Papproni/stm_audio_board_v3_dsp_board/stm_audio_board_V3/stm_audio_board_V3.kicad_pcb

## KiCad design stm_audio_board_V3/stm_audio_board_V3.kicad_pcb (2024-04-08)

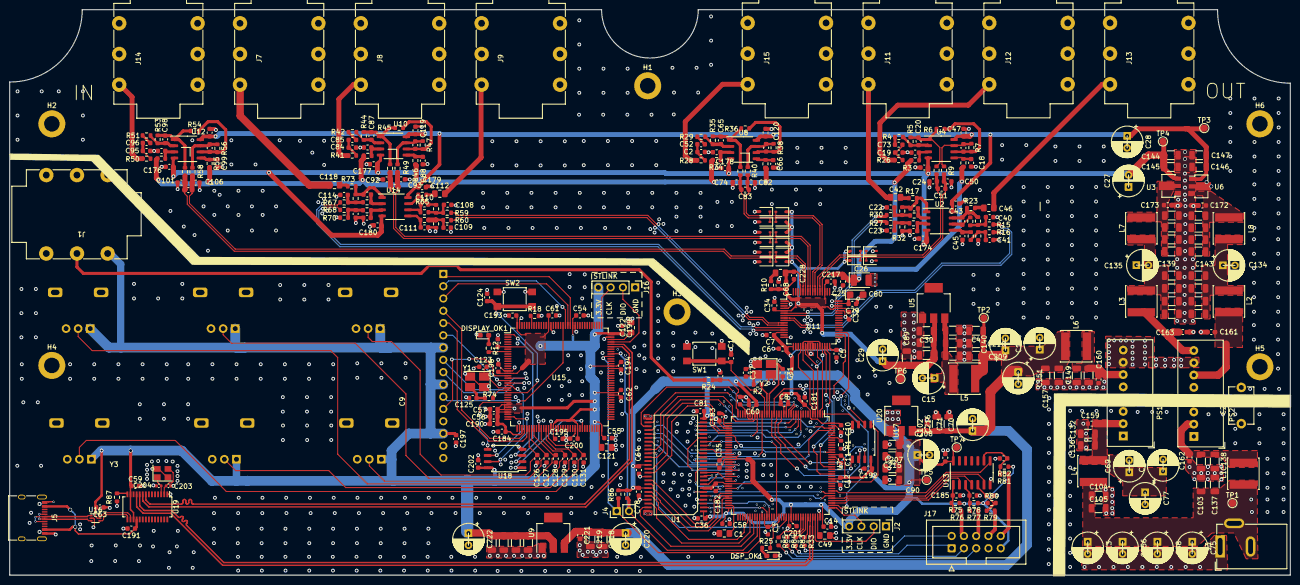
[picture p1: board stm_audio_board_V3.kicad_pcb from above]

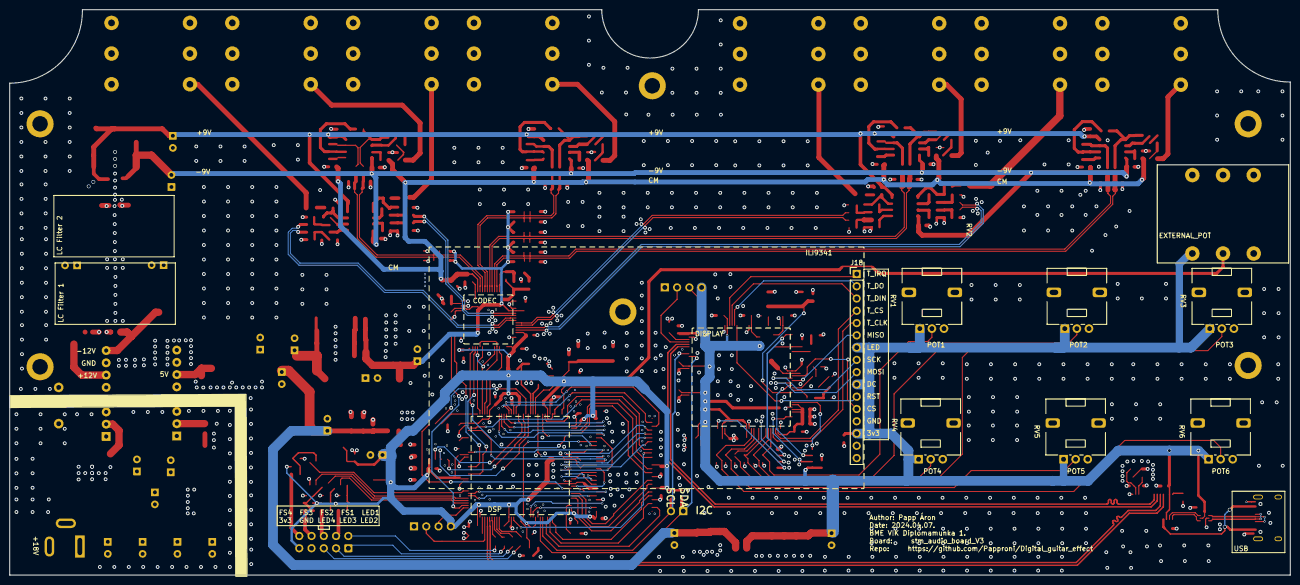
[picture p2: board stm_audio_board_V3.kicad_pcb from below]

Board: 4 copper layers, 265.0 x 117.0 mm, 404 parts (7 on the bottom side), 232 nets.

Parts:
C1, C42, C46, C49, C112, C118, C121, C122: 2.2uF; C_0805_2012Metric_Pad1.18x1.45mm_HandSolder
C2, C19, C21, C38, C39, C44, C45, C51, C72, C83, C84, C91, C94, C95, C100, C107, C110, C111, C116, C117: 100pF; C_0603_1608Metric
C3, C5, C6, C7, C8, C9, C10, C11, C12, C14, C16, C17, C18, C25, C32, C33, C34, C35, C36, C43, C47, C52, C53, C54, C55, C56, C57, C58, C59, C60, C61, C62, C63, C64, C66, C73, C78, C79, C81, C85, C86, C88, C96, C97, C99, C102, C113, C119, C120, C124, C126, C127, C128, C129, C130, C131, C159, C160, C161, C162, C163, C172, C173, C174, C175, C176, C177, C178, C179, C180, C181, C182, C183, C184, C185, C186, C187, C188, C189, C190, C191, C192, C193, C194, C195, C196, C197, C198, C199, C200, C201, C202, C217, C221, C227: 100nF; C_0603_1608Metric
C4, C30, C71, C89, C90, C103, C104, C105, C132, C133, C136, C137, C138, C139, C141, C142, C143, C144, C145, C146, C147, C148, C149, C152, C153, C154, C155, C157, C158, C164, C165, C166, C167, C168, C169, C170, C171, C205, C206, C207, C209, C210, C211, C212, C213, C214, C215, C216, C218, C219, C223, C224, C225, C226: 10uF; C_1206_3216Metric
C13, C15, C27, C28, C29, C48, C69, C70, C75, C76, C77, C134, C135, C140, C150, C151, C156, C208, C220, C222: 100uF; CP_Radial_D6.3mm_P2.50mm_reference_fix
C20, C65, C87, C98: 1p; C_0603_1608Metric
C22, C23, C40, C41, C108, C109, C114, C115: 470pF; C_0603_1608Metric
C24, C50, C68, C74, C82, C92, C93, C101, C106, C228: 1nF; C_0603_1608Metric
C26: 100uF tantal; CP_EIA-3528-21_Kemet-B
C31, C37, C123, C125: 12pF; C_0603_1608Metric
C67: 33nF; C_0805_2012Metric_Pad1.18x1.45mm_HandSolder
C80: 10uF tantal; CP_EIA-3216-18_Kemet-A
C203, C204: 20pF; C_0402_1005Metric
C229: 1nF; C_Disc_D7.5mm_W5.0mm_P7.50mm
D1, D4, D5, D6, D7, D8, D9, D12, D13, D14, D15, D16, D17, D18, D19, D20: 1N5819; D_SOD-323
DISPLAY_OK1: LED; LED_0603_1608Metric_Pad1.05x0.95mm_HandSolder
DSP_OK1: LED; LED_0603_1608Metric_Pad1.05x0.95mm_HandSolder
H1, H2, H3, H4, H5, H6: MountingHole_Pad; MountingHole_3.2mm_M3_DIN965_Pad
J1: External_POT; 6.3_jack_new_ref
J2: STlink_DSP; PinHeader_1x04_P2.54mm_Vertical
J3: Barrel_Jack_Switch; BarrelJack_GCT_DCJ200-10-A_Horizontal
J4: Conn_01x02_i2c; PinHeader_1x02_P2.54mm_Vertical
J5: USB_C_Receptacle_USB2.0; USB_C_Receptacle_XKB_U262-16XN-4BVC11
J7: AudioJack_LOOP1_SEND; 6.3_jack_new_ref
J8: AudioJack_LOOP1_RETURN; 6.3_jack_new_ref
J9: AudioJack_LOOP2_SEND; 6.3_jack_new_ref
J11: AudioJack_LOOP3_SEND; 6.3_jack_new_ref
J12: AudioJack_LOOP3_RETURN; 6.3_jack_new_ref
J13: AudioJack_OUTPUT; 6.3_jack_new_ref
J14: AudioJack_INPUT; 6.3_jack_new_ref
J15: AudioJack_LOOP2_RETURN; 6.3_jack_new_ref
J16: STlink_DISP_MCU; PinHeader_1x04_P2.54mm_Vertical
J17: Conn_01x10_Footswitch; IDC-Header_2x05_P2.54mm_Vertical
J18: Conn_01x16_ILI9341; PinHeader_1x16_P2.54mm_Vertical
L1, L2, L3, L4, L5, L6, L7, L8: 10uH; L_Sunlord_SWPA6020S
PS1: URB2405S-6WR3; Converter_DCDC_XP_POWER-ITxxxxxS_THT
PS2: WRA2412S-3WR2; Converter_DCDC_XP_POWER-ITxxxxxS_THT
R1, R18, R75, R78, R80, R82: 10k; R_0603_1608Metric
R2, R3, R8, R9, R11, R24, R26, R28, R34, R37, R39, R40, R41, R43, R46, R48, R49, R50, R52, R55, R57, R58, R74: 100R; R_0603_1608Metric
R4, R29, R42, R51: 1M; R_0603_1608Metric
R5, R35, R44, R53: 510k; R_0603_1608Metric
R6, R7, R36, R38, R45, R47, R54, R56: 4k7; R_0603_1608Metric
R10, R13, R14, R15, R16, R19, R20, R21, R22, R27, R30, R31, R32, R59, R60, R61, R62, R63, R64, R66, R67, R68, R69, R70, R71, R72, R86: 3k; R_0603_1608Metric
R12, R17, R23, R25, R33, R65, R73, R76, R77, R79, R81, R83, R84, R85: 1k; R_0603_1608Metric
R87: 2.7k; R_0603_1608Metric
RV1, RV2, RV3, RV4, RV5, RV6: R_Potentiometer; Potentiometer_Alps_RK09L_Single_Vertical
SW1, SW2: SW_SPST; SW_SPST_TL3305A
TP1: TestPoint_PWR_IN; TestPoint_Pad_D1.5mm
TP2: TestPoint_5V; TestPoint_Pad_D1.5mm
TP3: TestPoint_9V; TestPoint_Pad_D1.5mm
TP4: TestPoint_-9V; TestPoint_Pad_D1.5mm
TP5, TP7: TestPoint_3V3; TestPoint_Pad_D1.5mm
TP6: TestPoint_3V3A; TestPoint_Pad_D1.5mm
U1: IS42S16100H-7TL; TSOP-2-50-new
U2, U4, U8, U10, U12, U14: OP275; SSOP-8_3.9x5.05mm_P1.27mm
U3: 7909; SOT-89-3
U5, U9, U20: AP1117-33; SOT-223
U6: 7809; SOT-89-3
U7, U15: STM32H723ZGTx; LQFP-144_20x20mm_P0.5mm
U11: LQFP-64_10x10mm_P0.5mm
U13: 74HC14; SOIC-14_3.9x8.7mm_P1.27mm
U16: USBLC6-2P6; SOT-666
U17, U18: W25Q128JVS; SOIC-8_5.23x5.23mm_P1.27mm
U19: FE1.1s; SSOP-28_3.9x9.9mm_P0.635mm
Y1, Y2: X1E0000210132; Crystal_SMD_SeikoEpson_TSX3225-4Pin_3.2x2.5mm_HandSoldering
Y3: Crystal_GND24; Crystal_SMD_3225-4Pin_3.2x2.5mm

Connections:
5V: C4.1, C70.1, C71.1, C102.1, C140.1, C148.1, C150.1, C151.1, C157.1, C209.1, C210.1, C216.1, C218.1, C219.1, C220.1, C221.1, L5.1, L6.2, TP2.1, U9.3 (VI), U20.3 (VI)
+3.3V: C3.1, C5.1, C6.1, C7.1, C8.1, C9.1, C10.1, C11.1, C12.1, C14.1, C35.1, C36.1, C54.1, C55.1, C56.1, C57.1, C58.1, C59.1, C60.1, C61.1, C62.1, C63.1, C64.1, C78.1, C81.1, C90.1, C181.1, C182.1, C183.1, C184.1, C189.1, C190.1, C192.1, C193.1, C194.1, C195.1, C196.1, C197.1, C198.1, C199.1, C200.1, C201.1, C202.1, C207.1, C208.1, C214.1, C215.1, C222.1, C223.1, C224.1, C225.1, C226.1, J1.T, J2.4, J16.4, J17.9, J18.7, J18.10, J18.14, R66.1, R75.1, R78.1, R80.1, R82.1, R86.1, RV1.1, RV2.1, RV3.1, RV4.1, RV5.1, RV6.1, TP5.1, TP7.1, U1.1 (VDD), U1.7 (VDDQ), U1.13 (VDDQ), U1.25 (VDD), U1.38 (VDDQ), U1.44 (VDDQ), U7.6 (VBAT), U7.17 (VDD), U7.30 (VDD), U7.32 (VREF+), U7.33 (VDDA), U7.39 (VDD), U7.52 (VDD), U7.62 (VDD), U7.72 (VDD), U7.84 (VDD), U7.95 (VDD33USB), U7.108 (VDD), U7.121 (VDD), U7.131 (VDD), U7.144 (VDD), U9.2 (VO), U11.14 (PD/RST), U11.17 (DVDD), U11.32 (DVDD), U13.14 (VCC), U15.6 (VBAT), U15.17 (VDD), U15.30 (VDD), U15.32 (VREF+), U15.33 (VDDA), U15.39 (VDD), U15.52 (VDD), U15.62 (VDD), U15.72 (VDD), U15.84 (VDD), U15.95 (VDD33USB), U15.108 (VDD), U15.121 (VDD), U15.131 (VDD), U15.144 (VDD), U16.5 (VBUS), U17.8 (VCC), U18.8 (VCC), U19.13 (VD33), U19.17 (~XRSTJ), U20.2 (VO)
+3.3VA: C29.1, C30.1, C32.1, C33.1, C34.1, C68.1, C89.1, C205.1, C206.1, C217.1, C228.1, D4.1 (K), D5.1 (K), D7.1 (K), D9.1 (K), D13.1 (K), D15.1 (K), D17.1 (K), D19.1 (K), R10.2, TP6.1, U5.2 (VO), U11.5 (AVDD), U11.45 (AVDD), U11.51 (AVDD), U11.62 (AVDD)
+9V: C28.1, C43.1, C47.1, C113.1, C119.1, C120.1, C146.1, C147.1, C179.1, TP3.1, U2.8 (V+), U4.8 (V+), U6.1 (OUT), U8.8 (V+), U10.8 (V+), U12.8 (V+), U14.8 (V+)
-9V: C27.2, C144.1, C145.1, C174.2, C175.2, C176.2, C177.2, C178.2, C180.2, TP4.1, U2.4 (V-), U3.3 (VO), U4.4 (V-), U8.4 (V-), U10.4 (V-), U12.4 (V-), U14.4 (V-)
/Display_Interface/MCU_Display/DISPLAY_FLASH_CLK: U15.22 (PF10), U18.6 (CLK)
/Display_Interface/MCU_Display/DISPLAY_FLASH_CS: U15.64 (PE11), U18.1 (~CS)
/Display_Interface/MCU_Display/DISPLAY_FLASH_D0: U15.29 (PC3_C), U18.5 (DI(IO0))
/Display_Interface/MCU_Display/DISPLAY_FLASH_D1: U15.46 (PB0), U18.2 (DO(IO1))
/Display_Interface/MCU_Display/DISPLAY_FLASH_D2: U15.1 (PE2), U18.3 (IO2)
/Display_Interface/MCU_Display/DISPLAY_FLASH_D3: U15.35 (PA1), U18.7 (IO3)
/Display_Interface/MCU_Display/ILI9341_DISPLAY_CLK: J18.8, U15.19 (PF7)
/Display_Interface/MCU_Display/ILI9341_DISPLAY_CS: J18.12, U15.18 (PF6)
/Display_Interface/MCU_Display/ILI9341_DISPLAY_MISO: J18.6, U15.20 (PF8)
/Display_Interface/MCU_Display/ILI9341_DISPLAY_MOSI: J18.9, U15.21 (PF9)
/Display_Interface/MCU_Display/ILI9341_DISPLAY_RESET: J18.11, U15.125 (PG10)
/Display_Interface/MCU_Display/ILI9341_TOUCH_CLK: J18.5, U15.41 (PA5)
/Display_Interface/MCU_Display/ILI9341_TOUCH_CS: J18.4, U15.40 (PA4)
/Display_Interface/MCU_Display/ILI9341_TOUCH_IRQ: J18.1, U15.122 (PD6)
/Display_Interface/MCU_Display/ILI9341_TOUCH_MISO: J18.2, U15.124 (PG9)
/Display_Interface/MCU_Display/ILI9341_TOUCH_MOSI: J18.3, U15.123 (PD7)
/Display_Interface/MCU_Display/NRST_2: C124.1, SW2.1 (A), U15.25 (NRST)
/MCU/DSP_FLASH_CLK: U7.22 (PF10), U17.6 (CLK)
/MCU/DSP_FLASH_CS: U7.64 (PE11), U17.1 (~CS)
/MCU/DSP_FLASH_D0: U7.20 (PF8), U17.5 (DI(IO0))
/MCU/DSP_FLASH_D1: U7.21 (PF9), U17.2 (DO(IO1))
/MCU/DSP_FLASH_D2: U7.1 (PE2), U17.3 (IO2)
/MCU/DSP_FLASH_D3: U7.18 (PF6), U17.7 (IO3)
/MCU/DSP_SDRAM_ADRESS_BUS0: U1.21 (A0), U7.10 (PF0)
/MCU/DSP_SDRAM_ADRESS_BUS1: U1.22 (A1), U7.11 (PF1)
/MCU/DSP_SDRAM_ADRESS_BUS2: U1.23 (A2), U7.12 (PF2)
/MCU/DSP_SDRAM_ADRESS_BUS3: U1.24 (A3), U7.13 (PF3)
/MCU/DSP_SDRAM_ADRESS_BUS4: U1.27 (A4), U7.14 (PF4)
/MCU/DSP_SDRAM_ADRESS_BUS5: U1.28 (A5), U7.15 (PF5)
/MCU/DSP_SDRAM_ADRESS_BUS6: U1.29 (A6), U7.50 (PF12)
/MCU/DSP_SDRAM_ADRESS_BUS7: U1.30 (A7), U7.53 (PF13)
/MCU/DSP_SDRAM_ADRESS_BUS8: U1.31 (A8), U7.54 (PF14)
/MCU/DSP_SDRAM_ADRESS_BUS9: U1.32 (A9), U7.55 (PF15)
/MCU/DSP_SDRAM_ADRESS_BUS10: U1.20 (A10), U7.56 (PG0)
/MCU/DSP_SDRAM_ADRESS_BUS11: U1.19 (A11), U7.89 (PG4)
/MCU/DSP_SDRAM_CAS: U1.16 (/CAS), U7.132 (PG15)
/MCU/DSP_SDRAM_CKE: U1.34 (CKE), U7.29 (PC3_C)
/MCU/DSP_SDRAM_CLK: U1.35 (CLK), U7.93 (PG8)
/MCU/DSP_SDRAM_CS: U1.18 (/CS), U7.28 (PC2_C)
/MCU/DSP_SDRAM_DATA_BUS0: U1.2 (DQ0), U7.85 (PD14)
/MCU/DSP_SDRAM_DATA_BUS1: U1.3 (DQ1), U7.86 (PD15)
/MCU/DSP_SDRAM_DATA_BUS2: U1.5 (DQ2), U7.114 (PD0)
/MCU/DSP_SDRAM_DATA_BUS3: U1.6 (DQ3), U7.115 (PD1)
/MCU/DSP_SDRAM_DATA_BUS4: U1.8 (DQ4), U7.58 (PE7)
/MCU/DSP_SDRAM_DATA_BUS5: U1.9 (DQ5), U7.59 (PE8)
/MCU/DSP_SDRAM_DATA_BUS6: U1.11 (DQ6), U7.60 (PE9)
/MCU/DSP_SDRAM_DATA_BUS7: U1.12 (DQ7), U7.63 (PE10)
/MCU/DSP_SDRAM_DATA_BUS8: U1.39 (DQ8), U7.40 (PA4)
/MCU/DSP_SDRAM_DATA_BUS9: U1.40 (DQ9), U7.41 (PA5)
/MCU/DSP_SDRAM_DATA_BUS10: U1.42 (DQ10), U7.66 (PE13)
/MCU/DSP_SDRAM_DATA_BUS11: U1.43 (DQ11), U7.67 (PE14)
/MCU/DSP_SDRAM_DATA_BUS12: U1.45 (DQ12), U7.68 (PE15)
/MCU/DSP_SDRAM_DATA_BUS13: U1.46 (DQ13), U7.77 (PD8)
/MCU/DSP_SDRAM_DATA_BUS14: U1.48 (DQ14), U7.78 (PD9)
/MCU/DSP_SDRAM_DATA_BUS15: U1.49 (DQ15), U7.79 (PD10)
/MCU/DSP_SDRAM_LDQM: U1.14 (LDQM), U7.141 (PE0)
/MCU/DSP_SDRAM_RAS: U1.17 (/RAS), U7.49 (PF11)
/MCU/DSP_SDRAM_UDQM: U1.36 (UDQM), U7.142 (PE1)
/MCU/DSP_SDRAM_WE: U1.15 (/WE), U7.26 (PC0)
/MCU/NRST: C16.1, SW1.1 (A), U7.25 (NRST)
/MCU/USB_Conn_D+: J5.A6 (D+), J5.B6 (D+), U16.1 (I/O1)
/MCU/USB_Conn_D-: J5.A7 (D-), J5.B7 (D-), U16.3 (I/O2)
/Power/+12V: C161.1, L2.1, PS2.6 (+Vout)
/Power/-12V: C163.1, L3.1, PS2.8 (-Vout)
AD1939_CM: C25.2, C26.1, R3.2, R11.2, R34.2, R37.2, R43.2, R46.2, R52.2, R55.2, U11.52 (CM)
AD1939_FILTR: C79.2, C80.1, U11.47 (FILTR)
AD1939_LF: C67.2, C68.2, C228.2, U11.61 (LF)
AD1939_SAI1A_CK: U7.4 (PE5), U11.21 (DBCLK), U11.28 (ABCLK)
AD1939_SAI1A_SDO: U7.5 (PE6), U11.20 (DSDATA1)
AD1939_SAI1A_WS: U7.3 (PE4), U11.22 (DLRCLK), U11.29 (ALRCLK)
AD1939_SAI1B_SDI: U7.2 (PE3), U11.27 (ASDATA1)
AD1939_SPI_CLK: U7.126 (PG11), U11.34 (CCLK)
AD1939_SPI_CS: U7.110 (PA15(JTDI)), U11.35 (CLATCH)
AD1939_SPI_MISO: U7.42 (PA6), U11.31 (COUT)
AD1939_SPI_MOSI: U7.123 (PD7), U11.30 (CIN)
ADC1N: C24.2, C51.2, D5.2 (A), D6.1 (K), R8.1, U11.54 (ADC1LN)
ADC1P: C50.1, C51.1, D1.1 (K), D4.2 (A), R9.1, U11.53 (ADC1LP)
ADC2N: C74.2, C83.2, D7.2 (A), D8.1 (K), R39.1, U11.56 (ADC1RN)
ADC2P: C82.1, C83.1, D9.2 (A), D12.1 (K), R40.1, U11.55 (ADC1RP)
ADC3N: C92.2, C94.2, D17.2 (A), D18.1 (K), R48.1, U11.58 (ADC2LN)
ADC3P: C93.1, C94.1, D19.2 (A), D20.1 (K), R49.1, U11.57 (ADC2LP)
ADC4N: C101.2, C107.2, D13.2 (A), D14.1 (K), R57.1, U11.60 (ADC2RN)
ADC4P: C106.1, C107.1, D15.2 (A), D16.1 (K), R58.1, U11.59 (ADC2RP)
Audio_Loop1_Return: J8.T, R41.1
Audio_Loop1_Send: C118.2, J7.T
Audio_Loop2_Return: J15.T, R28.1
Audio_Loop2_Send: C112.2, J9.T
Audio_Loop3_Return: J12.T, R26.1
Audio_Loop3_Send: C42.2, J11.T
Audio_Main_Input: J14.T, R50.1
Audio_Main_Output: C46.2, J13.T
DAC1N: R15.1, U11.9 (OR3N)
DAC1P: R16.1, U11.8 (OR3P)
DAC2N: R27.1, U11.7 (OL3N)
DAC2P: R30.1, U11.6 (OL3P)
DAC3N: R67.1, U11.13 (OR4N)
DAC3P: R68.1, U11.12 (OR4P)
DAC4N: R60.1, U11.11 (OL4N)
DAC4P: R59.1, U11.10 (OL4P)
DISPLAY_OK_LED: R12.2, U15.8 (PC14)
DISPLAY_USB_HS_D+: U15.104 (PA12), U19.9 (DP2)
DISPLAY_USB_HS_D-: U15.103 (PA11), U19.8 (DM2)
DSP_OK_LED: R25.2, U7.90 (PG5)
DSP_USB_HS_D+: U7.104 (PA12), U19.11 (DP1)
DSP_USB_HS_D-: U7.103 (PA11), U19.10 (DM1)
EXT_POT_ADC: C227.1, R24.1, U7.36 (PA2)
Earth: C13.2, C48.2, C69.2, C75.2, C76.2, C77.2, C103.2, C104.2, C105.2, C132.2, C133.2, C136.2, C137.2, C138.2, C156.2, C159.2, C162.2, C229.1, J3.1, PS1.1 (-Vin), PS2.1 (-Vin)
Footswitch_1: J17.4, R76.1
Footswitch_1_INTERRUPT_PIN: U7.111 (PC10), U13.2
Footswitch_2: J17.6, R77.1
Footswitch_2_INTERRUPT_PIN: U7.112 (PC11), U13.4
Footswitch_3: J17.8, R79.1
Footswitch_3_INTERRUPT_PIN: U7.113 (PC12), U13.6
Footswitch_4: J17.10, R81.1
Footswitch_4_INTERRUPT_PIN: U7.116 (PD2), U13.8
GND: C1.2, C2.1, C3.2, C4.2, C5.2, C6.2, C7.2, C8.2, C9.2, C10.2, C11.2, C12.2, C14.2, C15.2, C16.2, C17.2, C18.2, C19.1, C22.1, C23.2, C24.1, C25.1, C26.2, C27.1, C28.2, C29.2, C30.2, C31.1, C32.2, C33.2, C34.2, C35.2, C36.2, C37.1, C38.1, C40.1, C41.2, C43.2, C45.1, C47.2, C49.2, C50.2, C53.2, C54.2, C55.2, C56.2, C57.2, C58.2, C59.2, C60.2, C61.2, C62.2, C63.2, C64.2, C66.2, C70.2, C71.2, C74.1, C78.2, C79.1, C80.2, C81.2, C82.2, C84.1, C86.2, C88.2, C89.2, C90.2, C92.1, C93.2, C95.1, C97.2, C99.2, C101.1, C102.2, C106.2, C108.1, C109.2, C111.1, C113.2, C114.1, C115.2, C117.1, C119.2, C120.2, C121.2, C122.2, C123.1, C124.2, C125.1, C126.2, C127.2, C128.2, C129.2, C130.2, C131.2, C134.2, C135.1, C139.2, C140.2, C141.2, C142.2, C143.2, C144.2, C145.2, C146.2, C147.2, C148.2, C149.2, C150.2, C151.2, C152.2, C153.2, C154.2, C155.2, C157.2, C158.2, C160.2, C161.2, C163.2, C164.2, C165.2, C166.2, C167.2, C168.2, C169.2, C170.2, C171.2, C172.2, C173.2, C174.1, C175.1, C176.1, C177.1, C178.1, C179.2, C180.1, C181.2, C182.2, C183.2, C184.2, C185.2, C186.2, C187.2, C188.2, C189.2, C190.2, C191.2, C192.2, C193.2, C194.2, C195.2, C196.2, C197.2, C198.2, C199.2, C200.2, C201.2, C202.2, C203.1, C204.2, C205.2, C206.2, C207.2, C208.2, C209.2, C210.2, C211.2, C212.2, C213.2, C214.2, C215.2, C216.2, C217.2, C218.2, C219.2, C220.2, C221.2, C222.2, C223.2, C224.2, C225.2, C226.2, C227.2, C229.2, D1.2 (A), D6.2 (A), D8.2 (A), D12.2 (A), D14.2 (A), D16.2 (A), D18.2 (A), D20.2 (A), DISPLAY_OK1.1 (K), DSP_OK1.1 (K), H1.1, H2.1, H3.1, H4.1, H5.1, H6.1, J1.RN, J1.S, J2.1, J5.A1 (GND), J5.A12 (GND), J5.B1 (GND), J5.B12 (GND), J8.TN, J12.TN, J14.TN, J15.TN, J16.1, J17.7, J18.13, PS1.7 (-Vout), PS2.7 (Common), R1.2, R18.2, R20.1, R32.1, R62.1, R70.1, R87.2, RV1.3, RV2.3, RV3.3, RV4.3, RV5.3, RV6.3, SW1.2 (B), SW2.2 (B), U1.4 (GNDQ), U1.10 (GNDQ), U1.26 (GND), U1.41 (GNDQ), U1.47 (GNDQ), U1.50 (GND), U3.1 (GND), U5.1 (GND), U6.2 (GND), U7.16 (VSS), U7.31 (VSSA), U7.38 (VSS), U7.51 (VSS), U7.61 (VSS), U7.83 (VSS), U7.94 (VSS), U7.107 (VSS), U7.120 (VSS), U7.130 (VSS), U7.143 (PDR_ON), U9.1 (GND), U11.1 (AGND), U11.4 (AGND), U11.16 (DGND), U11.23 (VSUPPLY), U11.24 (VSENSE), U11.25 (VDRIVE), U11.33 (DGND), U11.44 (AGND), U11.46 (AGND), U11.48 (AGND), U13.7 (GND), U15.16 (VSS), U15.31 (VSSA), U15.38 (VSS), U15.51 (VSS), U15.61 (VSS), U15.83 (VSS), U15.94 (VSS), U15.107 (VSS), U15.120 (VSS), U15.130 (VSS), U15.143 (PDR_ON), U16.2 (GND), U17.4 (GND), U18.4 (GND), U19.1 (VSS), U20.1 (GND), Y1.2, Y1.4, Y2.2, Y2.4, Y3.2, Y3.4
I2C_SCL: J4.2, R66.2, U7.81 (PD12), U15.100 (PA8)
I2C_SDA: J4.1, R86.2, U7.82 (PD13), U15.99 (PC9)
LED1: J17.2, R33.2
LED1_PIN: R33.1, U7.102 (PA10)
LED2: J17.1, R83.2
LED2_PIN: R83.1, U7.101 (PA9)
LED3: J17.3, R84.2
LED3_PIN: R84.1, U7.100 (PA8)
LED4: J17.5, R85.2
LED4_PIN: R85.1, U7.99 (PC9)
unnamed: C1.1, U7.71 (VCAP)
unnamed: C2.2, C52.2, R28.2
unnamed: C19.2, C73.2, R26.2
unnamed: C20.2, R5.1, R6.2, R8.2, U4.1
unnamed: C21.2, R7.1, R9.2, U4.7
unnamed: C22.2, R13.1, R30.2, R31.1
unnamed: C23.1, R14.2, R27.2, R32.2
unnamed: C37.2, R2.2, Y2.3
unnamed: C39.2, R17.2, R31.2, U2.1
unnamed: C40.2, R15.2, R19.1, R21.1
unnamed: C41.1, R16.2, R20.2, R22.2
unnamed: C42.1, R17.1
unnamed: C44.2, R19.2, R23.2, U2.7
unnamed: C46.1, R23.1
unnamed: C49.1, U7.106 (VCAP)
unnamed: C52.1, R29.2
unnamed: C65.2, R35.1, R36.2, R39.2, U8.1
unnamed: C67.1, R10.1
unnamed: C72.2, R38.1, R40.2, U8.7
unnamed: C73.1, R4.2
unnamed: C84.2, C85.2, R41.2
unnamed: C85.1, R42.2
unnamed: C87.2, R44.1, R45.2, R48.2, U10.1
unnamed: C91.2, R47.1, R49.2, U10.7
unnamed: C95.2, C96.2, R50.2
unnamed: C96.1, R51.2
unnamed: C98.2, R53.1, R54.2, R57.2, U12.1
unnamed: C100.2, R56.1, R58.2, U12.7
unnamed: C108.2, R59.2, R61.1, R63.1
unnamed: C109.1, R60.2, R62.2, R64.2
unnamed: C110.2, R61.2, R65.2, U14.7
unnamed: C112.1, R65.1
unnamed: C114.2, R67.2, R69.1, R71.1
unnamed: C115.1, R68.2, R70.2, R72.2
unnamed: C116.2, R69.2, R73.2, U14.1
unnamed: C118.1, R73.1
unnamed: C121.1, U15.71 (VCAP)
unnamed: C122.1, U15.106 (VCAP)
unnamed: C125.2, R74.2, Y1.3
unnamed: C134.1, C142.1, C143.1, C152.1, C153.1, L2.2, L8.1
unnamed: C135.2, C139.1, C141.1, C154.1, C155.1, L3.2, L7.1
unnamed: C185.1, R75.2, R76.2, U13.1
unnamed: C186.1, R77.2, R78.2, U13.3
unnamed: C187.1, R79.2, R80.2, U13.5
unnamed: C188.1, R81.2, R82.2, U13.9
unnamed: DISPLAY_OK1.2 (A), R12.1
unnamed: DSP_OK1.2 (A), R25.1
unnamed: J1.R, R24.2
unnamed: C69.1, C76.1, C77.1, C132.1, C136.1, C159.1, L4.2, PS1.2 (+Vin)
unnamed: C149.1, C158.1, C160.1, L6.1, PS1.6 (+Vout)
unnamed: C133.1, C138.1, C162.1, L1.2, PS2.2 (+Vin)
unnamed: C38.2, R14.1, U2.3 (+)
unnamed: C39.1, R13.2, U2.2 (-)
unnamed: C45.2, R22.1, U2.5 (+)
unnamed: C44.1, R21.2, U2.6 (-)
unnamed: C165.1, C166.1, C167.1, C168.1, C173.1, L7.2, U3.2 (VI)
unnamed: C17.1, R3.1, U4.3 (+)
unnamed: C20.1, R4.1, R5.2, U4.2 (-)
unnamed: C18.1, R11.1, U4.5 (+)
unnamed: C21.1, R6.1, R7.2, U4.6 (-)
unnamed: C15.1, C211.1, C212.1, C213.1, L5.2, U5.3 (VI)
unnamed: C164.1, C169.1, C170.1, C171.1, C172.1, L8.2, U6.3 (IN)
unnamed: R1.1, U7.138 (BOOT0)
unnamed: C53.1, R34.1, U8.3 (+)
unnamed: C65.1, R29.1, R35.2, U8.2 (-)
unnamed: C66.1, R37.1, U8.5 (+)
unnamed: C72.1, R36.1, R38.2, U8.6 (-)
unnamed: C86.1, R43.1, U10.3 (+)
unnamed: C87.1, R42.1, R44.2, U10.2 (-)
unnamed: C88.1, R46.1, U10.5 (+)
unnamed: C91.1, R45.1, R47.2, U10.6 (-)
unnamed: C97.1, R52.1, U12.3 (+)
unnamed: C98.1, R51.1, R53.2, U12.2 (-)
unnamed: C99.1, R55.1, U12.5 (+)
unnamed: C100.1, R54.1, R56.2, U12.6 (-)
unnamed: C117.2, R72.1, U14.3 (+)
unnamed: C116.1, R71.2, U14.2 (-)
unnamed: C111.2, R64.1, U14.5 (+)
unnamed: C110.1, R63.2, U14.6 (-)
unnamed: R18.1, U15.138 (BOOT0)
unnamed: U16.4 (I/O2), U19.15 (DMU)
unnamed: U16.6 (I/O1), U19.16 (DPU)
unnamed: R87.1, U19.14 (REXT)
unnamed: C191.1, J5.A4 (VBUS), J5.A9 (VBUS), J5.B4 (VBUS), J5.B9 (VBUS), U19.18 (VBUSM)
unnamed: C204.1, U19.3 (XIN), Y3.1
unnamed: C203.2, U19.2 (XOUT), Y3.3
OSC0: C31.2, U7.23 (PH0), Y2.1
OSC0_2: C123.2, U15.23 (PH0), Y1.1
OSC1: R2.1, U7.24 (PH1)
OSC1_2: R74.1, U15.24 (PH1)
POT1: C126.1, RV1.2, U15.42 (PA6)
POT2: C127.1, RV2.2, U15.43 (PA7)
POT3: C129.1, RV3.2, U15.47 (PB1)
POT4: C128.1, RV4.2, U15.44 (PC4)
POT5: C130.1, RV5.2, U15.49 (PF11)
POT6: C131.1, RV6.2, U15.50 (PF12)
PWR_INPUT_12V-18V: C13.1, C48.1, C75.1, C103.1, C104.1, C105.1, C137.1, C156.1, J3.2, J3.3, L1.1, L4.1, TP1.1
SWCLK_DISP: J16.3, U15.109 (PA14(JTCK)
SWCLK_DSP: J2.3, U7.109 (PA14(JTCK)
SWDIO_DISP: J16.2, U15.105 (PA13(JTMS)
SWDIO_DSP: J2.2, U7.105 (PA13(JTMS)
