Papproni/stm_audio_board_v3_dsp_board/(commit log)

2024-02-25 Copies from old work
    [Connectors.kicad_sch, Footswitch.kicad_sch, Input_stage.kicad_sch, MCU.kicad_sch, Output_stage.kicad_sch, PINOUT_V3_2024_02_20.csv, Power.kicad_sch, codec.kicad_sch]
2024-02-26 SDRAM symbol added
    [MCU.kicad_sch, Power.kicad_sch, stm_audio_board_V3.kicad_pcb]
2024-02-27 Footprint tsop-2-50 added
2024-02-27 new sdram footprint created
2024-02-27 pcb redesign
    [MCU.kicad_sch, Power.kicad_sch, stm_audio_board_V3.kicad_pcb]
2024-03-03 Input and output stages are made and assembly started on pcb view
    [Audio_Connectors.kicad_sch, Input_stage.kicad_sch, MCU.kicad_sch, Output_stage.kicad_sch, Power.kicad_sch, codec.kicad_sch, filters.kicad_sch, potentiometers.kicad_sch]
2024-03-06 Input output connected to codec
    [MCU.kicad_sch, Output_stage.kicad_sch, codec.kicad_sch, potentiometers.kicad_sch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]
2024-03-08 minor changes
    [Connectors.kicad_sch, Display_Interface.kicad_sch, Input_stage.kicad_sch, MCU_Display.kicad_sch, Power.kicad_sch, codec.kicad_sch, potentiometers.kicad_sch, stm_audio_board_V3.kicad_pcb]
2024-03-17 +-12 DCDC added
    [Power.kicad_sch, potentiometers.kicad_sch]
2024-03-19 isolated power section done
    [Power.kicad_sch, stm_audio_board_V3.kicad_pcb]
2024-03-19 minor power section fixes
    [stm_audio_board_V3.kicad_pcb]
2024-03-19 safety commit
    [Power.kicad_sch, stm_audio_board_V3.kicad_pcb]
2024-03-21 Analog power and SDRAm routing reworked
    [Input_stage.kicad_sch, MCU.kicad_sch, Power.kicad_sch, stm_audio_board_V3.kicad_pcb]
2024-03-24 Footswitch debounce added
    [MCU.kicad_sch, Power.kicad_sch, filters.kicad_sch, stm_audio_board_V3.kicad_pcb, taptempo.kicad_sch]
2024-03-24 USB added
    [MCU.kicad_sch, Power.kicad_sch, stm_audio_board_V3.kicad_pcb]
2024-03-26 New orientation, Overvoltage protection added
    [Input_stage.kicad_sch, MCU.kicad_sch, MCU_Display.kicad_sch, filters.kicad_sch, stm_audio_board_V3.kicad_pcb]
2024-03-28 Testpoints and parts for usb hub added
    [MCU.kicad_sch, MCU_Display.kicad_sch, Power.kicad_sch, stm_audio_board_V3.kicad_pcb]
2024-03-30 Reworked outline for enclosure
    [Audio_Connectors.kicad_sch, Input_stage.kicad_sch, MCU.kicad_sch, MCU_Display.kicad_sch, Output_stage.kicad_sch, codec.kicad_sch, stm_audio_board_V3.kicad_pcb]
2024-03-30 1117 regulator added
2024-03-30 minor commit
    [Connectors.kicad_sch, Power.kicad_sch, filters.kicad_sch, stm_audio_board_V3.kicad_pcb]
2024-03-31 gnd vias added, footswitch mux connected
    [MCU.kicad_sch, Power.kicad_sch, codec.kicad_sch, filters.kicad_sch, stm_audio_board_V3.kicad_pcb, taptempo.kicad_sch]
2024-04-02 added external pot, added feedback leds, added I2C between MCUs
    [Power.kicad_sch, taptempo.kicad_sch]
2024-04-03 PCB design is finished
    [Audio_Connectors.kicad_sch, Connectors.kicad_sch, MCU.kicad_sch, MCU_Display.kicad_sch, potentiometers.kicad_sch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]
2024-04-06 minor changes to components
    [Audio_Connectors.kicad_sch, Connectors.kicad_sch, Input_stage.kicad_sch, MCU.kicad_sch, MCU_Display.kicad_sch, Output_stage.kicad_sch, Power.kicad_sch, codec.kicad_sch]
2024-04-07 added silkscreen captions, capacitor between gnd and earth
    [Audio_Connectors.kicad_sch, Connectors.kicad_sch, MCU.kicad_sch, Power.kicad_sch, potentiometers.kicad_sch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]
2024-04-07 gerber created
    [stm_audio_board_V3-B_Cu.gbl, stm_audio_board_V3-B_Mask.gbs, stm_audio_board_V3-B_Paste.gbp, stm_audio_board_V3-B_Silkscreen.gbo, stm_audio_board_V3-Edge_Cuts.gm1, stm_audio_board_V3-F_Cu.gtl, stm_audio_board_V3-F_Mask.gts, stm_audio_board_V3-F_Paste.gtp]
2024-04-08 Via size increased for economical reasons
    [MCU.kicad_sch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]
